UniversalScientificTechnologies/MRAKOMER2/mrakomer2_Small.jpg

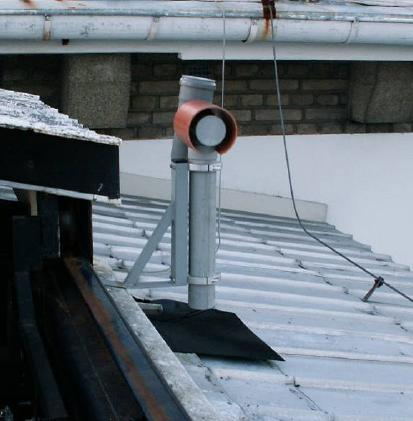
mrakomer2_Small.jpg
