UniversalScientificTechnologies/MRAKOMER2/PrjInfo.txt

//
// This is a project description file.
//

[InfoShortDescription.en]
Mrakomer (Clouds sensor) 

[InfoShortDescription.cs]
Mrakoměr
  
[InfoLongDescription.en]
Cloudsmeter is a robotics device for measurement the clouds coverage. This device is especially constructed for protection of robotics telescopes against rain and snow.

[InfoLongDescription.cs]
Robotický přístroj pro detekci oblačnosti. Byl navržen pro detekci možnosti nebezpečných srážek jako součást robotických dalekohledů.

[End]
