UniversalScientificTechnologies/MRAKOMER2/SCH/blocks.pdf

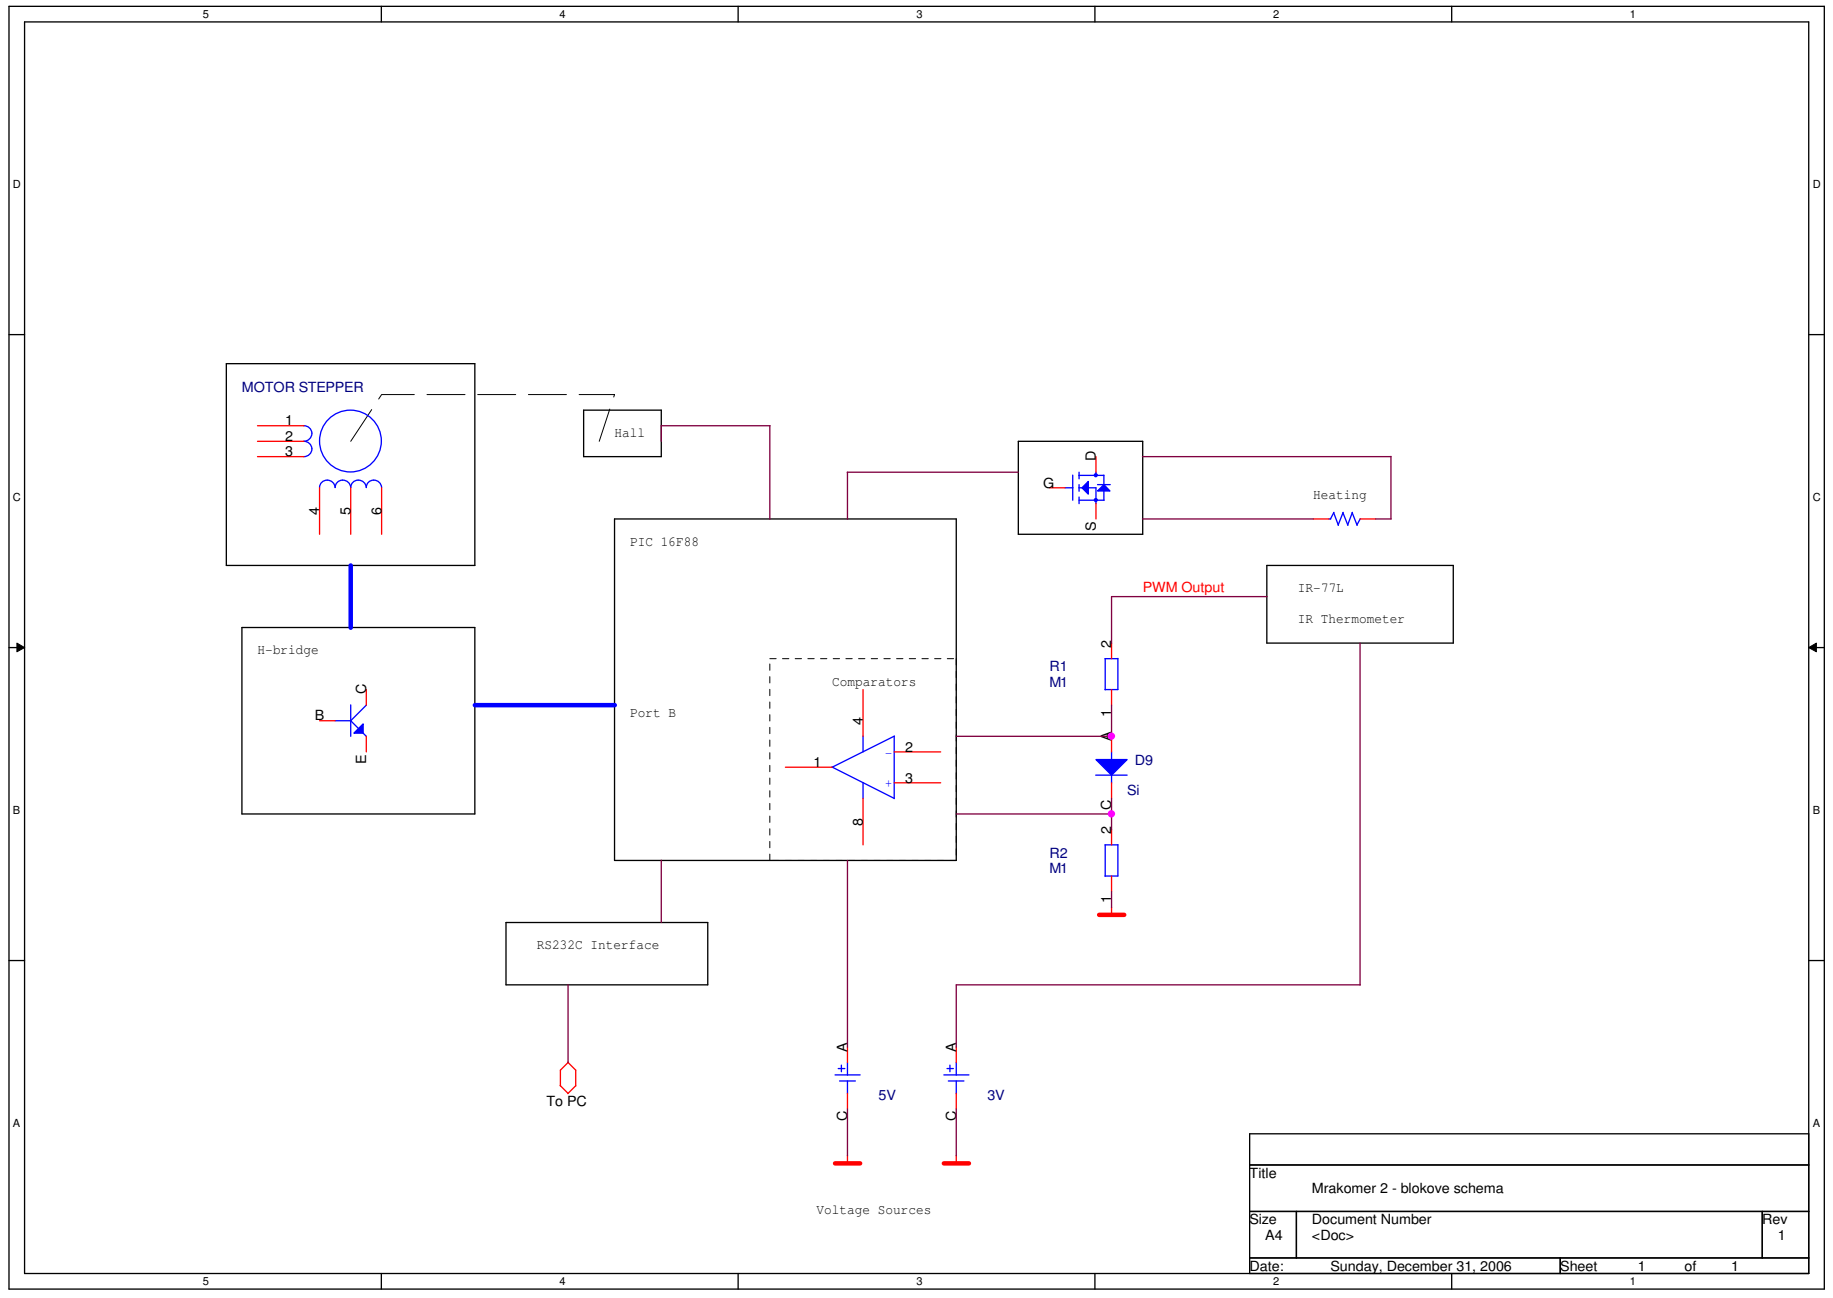
[picture p28: page 1]
Voltage Sources; IR Thermometer; PIC 16F88; Comparators; H-bridge; Port B; Hall; RS232C Interface; Heating; Title; PWM Output; MOTOR STEPPER

Mrakomer 2 - blokove schema

Size A4 | Document Number <Doc> | Rev 1

Date: Sunday, December 31, 2006 | Sheet 1 of 1
