UniversalScientificTechnologies/MRAKOMER2/SCH/mrakomer2.pdf

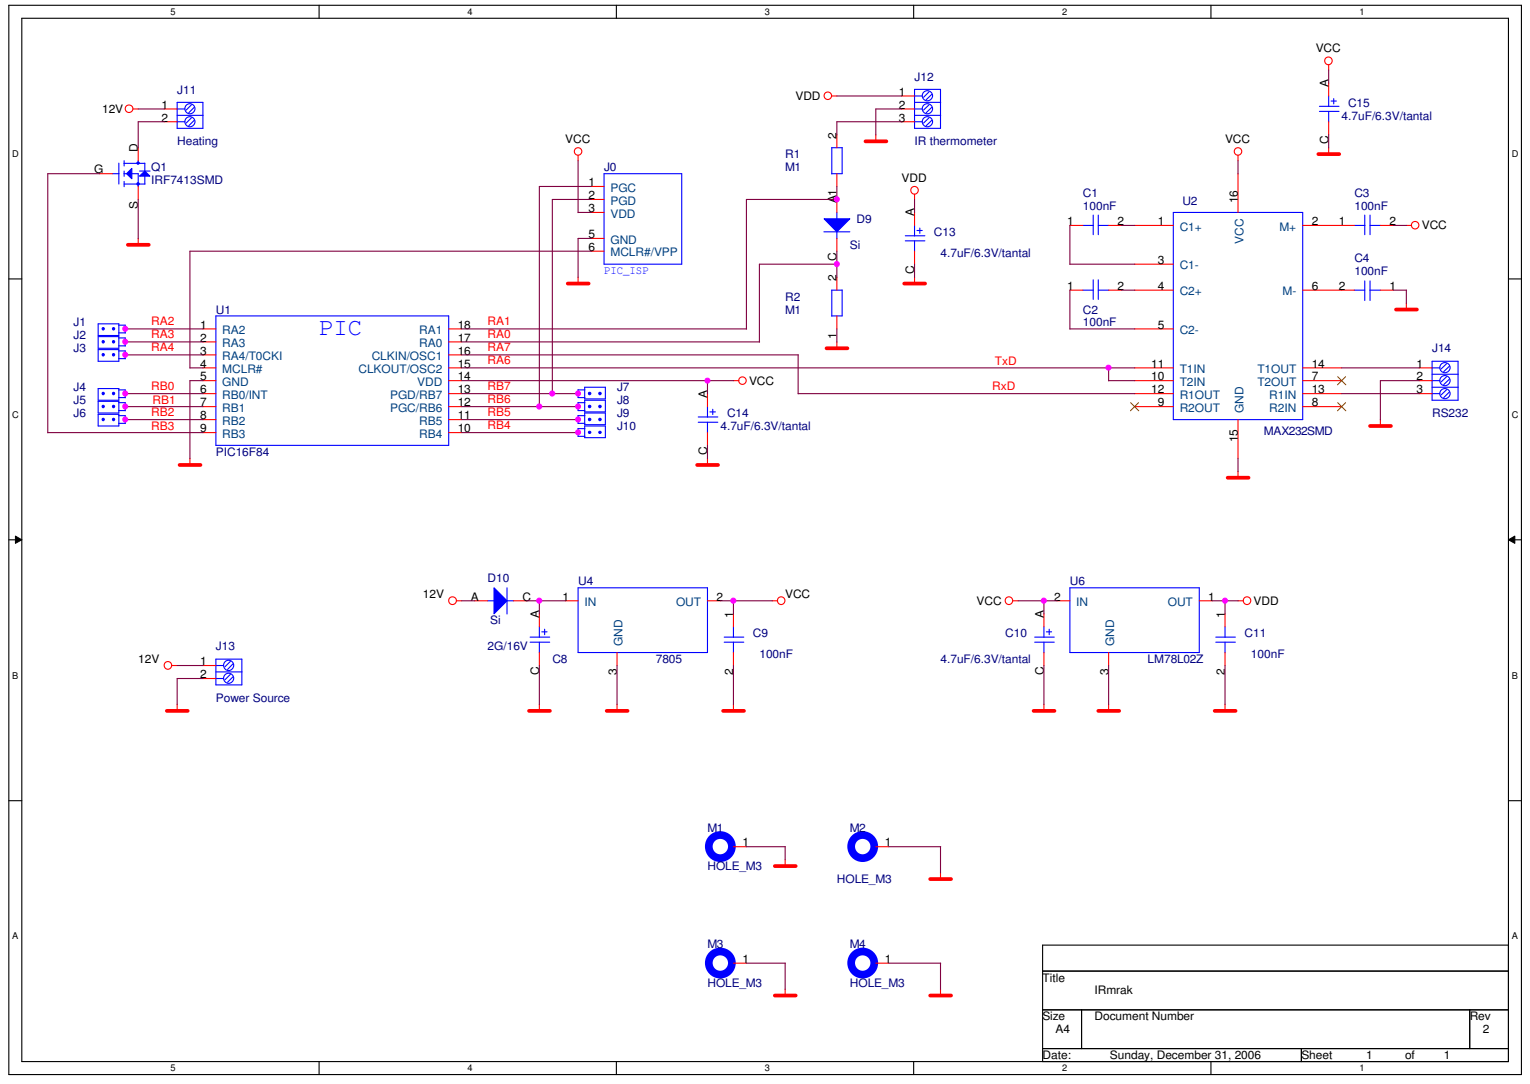
[picture p29: page 1]

VCC

RA0 17
RA7 16
15

Size A4 | Document Number | Rev 2

Date: Sunday, December 31, 2006 | Sheet 1 of 1
