UniversalScientificTechnologies/MRAKOMER2/DOC/schema.pdf

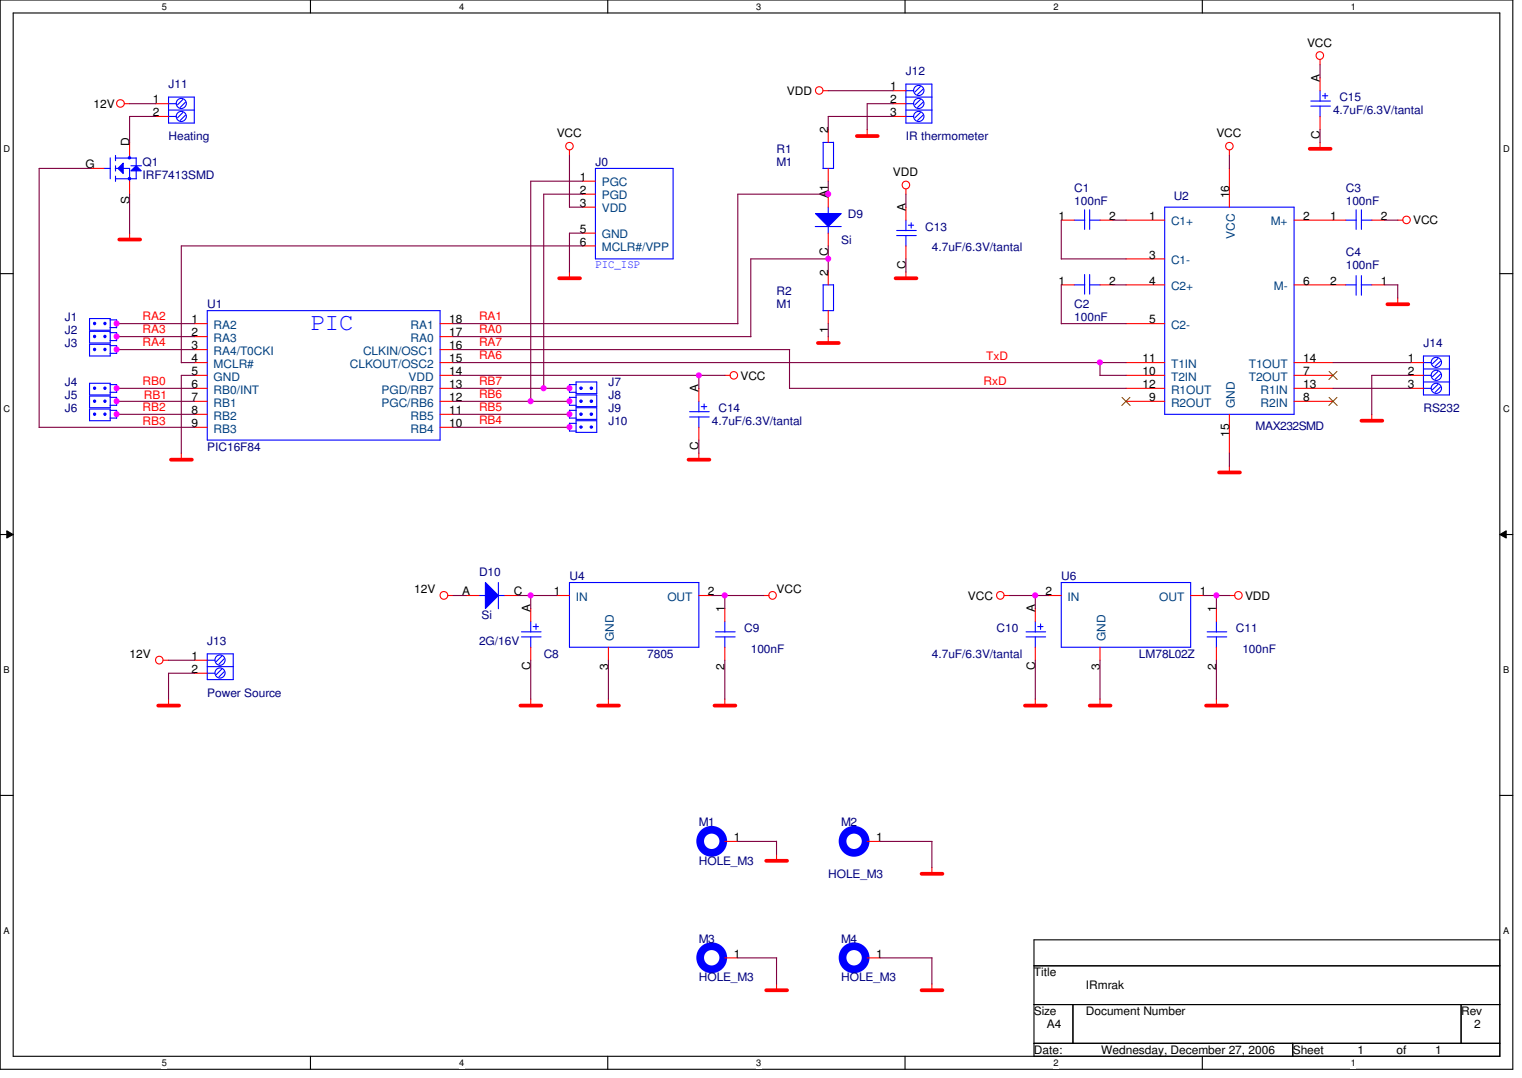
[picture p30: page 1]

RA0 17
RA7 16
15

Size A4 | Document Number | Rev 2

Date: Wednesday, December 27, 2006 | Sheet 1 of 1
