UniversalScientificTechnologies/MRAKOMER2/CAM_AMA/BOARD.pdf

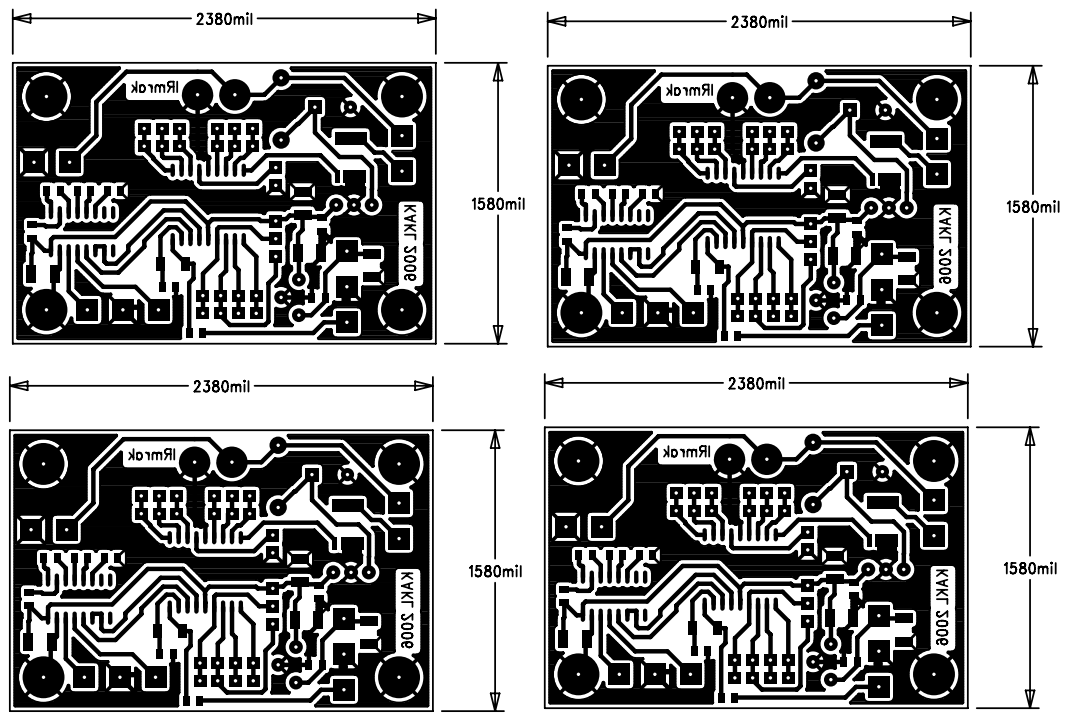
[picture p31: page 1]
