UniversalScientificTechnologies/MRAKOMER2/(list of files, drawings)

Other design files:
PCB/IRMRAK.pcb
SCH/BLOKOVE_SCHEMA.DSN
SCH/IRMRAK.DSN
